geekmomprojects/BendySAO/README.md

# BendySAO

Supercon 2024/2025 SAO Code and Design

Files for assembling and using the BendySAO. The design and code for this badge differs between the version released at SuperCon America 2024 and SuperCon Europe 2025. Please look in the correct subdirectory for your badge.
