geekmomprojects/BendySAO/SuperConEurope2025/README.md

Assembly and Programming instructions for the BendySAO for SuperCon Europe 2025
