geekmomprojects/BendySAO/(commit log)

2024-11-03 fixed missing loop to make animations run indefinitely
    [main_code_additions.py]
2025-03-14 Added Assembly instructions for SuperCon Europe
2025-03-15 Removed arduino build files
